alexcjang/24V-48V-Synchronous-Boost-Converter-for-Ebike/Documentation/Testing/22W_test.png

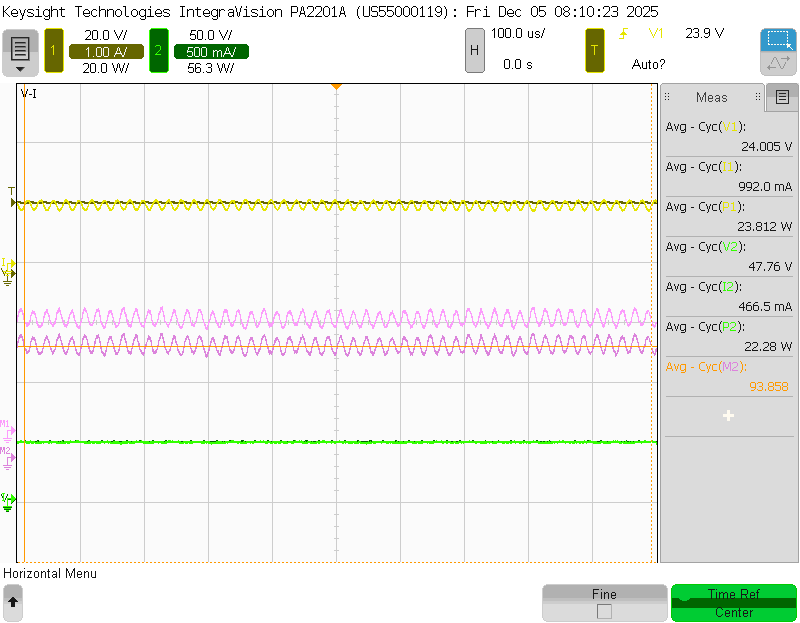
Documentation/Testing/22W_test.png
