alexcjang/24V-48V-Synchronous-Boost-Converter-for-Ebike/Documentation/Testing/91W_test.png

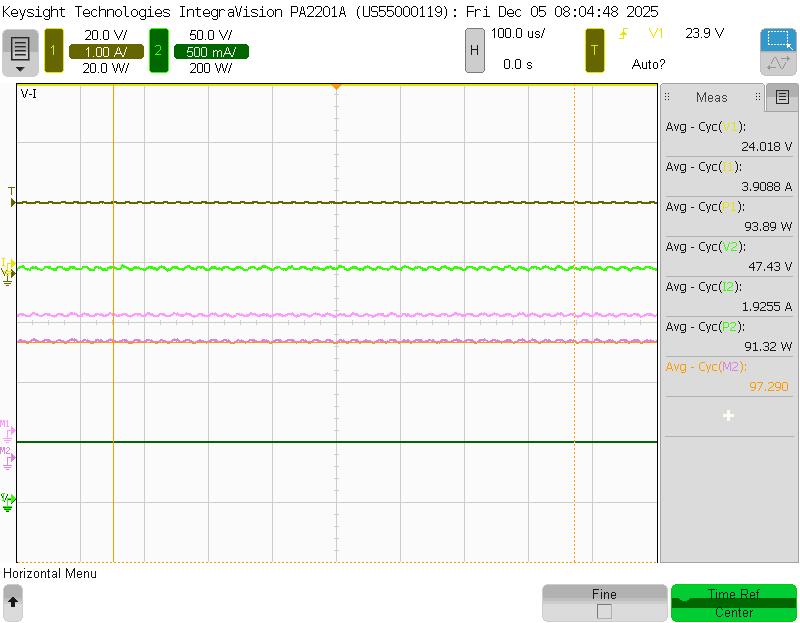
Documentation/Testing/91W_test.png
