alexcjang/24V-48V-Synchronous-Boost-Converter-for-Ebike/(commit log)

2026-08-10 Added pcb and schematic files for converter pcb
    Lab 2 starter schematic is final schematic, final pcb board file is the finished board
    [Lab2_starter.kicad_pcb, Lab2_starter.kicad_sch, PWR_LAB_PCB.kicad_pcb, final.kicad_pcb]
2026-08-10 Reorganized files and added lab reports
    [Lab2_starter.kicad_pcb, Lab2_starter.kicad_sch, PWR_LAB_PCB.kicad_pcb, final.kicad_pcb]
2026-08-23 Added oscilloscope screenshots of testing different output power
