alexcjang/24V-48V-Synchronous-Boost-Converter-for-Ebike/(notices)

Notices in the files:
parts and their libraries:
Copyright 2016 Accelerated Designs. All rights reserved.
